mkalkowski83/tank-level/README.md

# Tank Level Sensor / Czujnik poziomu tanku

| Language | Documentation |
|---|---|
| **English** | [README.en.md](README.en.md) |
| **Polski** | [README.pl.md](README.pl.md) |

Firmware (language-neutral): [`esphome/tank-level-sensor.yaml`](esphome/tank-level-sensor.yaml)
