mkalkowski83/tank-level/docs/README.md

# Documentation / Dokumentacja

## Schematics / Schematy

| Topic | English | Polski |
|---|---|---|
| Wiring diagram | [wiring-diagram.en.md](schematics/wiring-diagram.en.md) | [wiring-diagram.pl.md](schematics/wiring-diagram.pl.md) |
| DevKit connections | [connections-devkit.en.md](schematics/connections-devkit.en.md) | [connections-devkit.pl.md](schematics/connections-devkit.pl.md) |
| DevKit + AO3401A (active) | [connections-ao3401a.en.md](schematics/connections-ao3401a.en.md) | [connections-ao3401a.pl.md](schematics/connections-ao3401a.pl.md) |
| FireBeetle (target) | [connections-firebeetle.en.md](schematics/connections-firebeetle.en.md) | [connections-firebeetle.pl.md](schematics/connections-firebeetle.pl.md) |
| Schematic (KiCad PDF) | [tank-level-devkit.pdf](schematics/tank-level-devkit.pdf) | [tank-level-devkit.pdf](schematics/tank-level-devkit.pdf) |

## KiCad / KiCad

| Topic | Project |
|---|---|
| DevKit + AO3401A schematic | [tank-level-devkit.kicad_pro](kicad/tank-level-devkit/tank-level-devkit.kicad_pro) — [README.pl.md](kicad/tank-level-devkit/README.pl.md) |

## Design & plan / Specyfikacja i plan

| Document | English | Polski |
|---|---|---|
| Design spec | [design.en.md](superpowers/specs/2026-08-25-tank-level-sensor-design.en.md) | [design.pl.md](superpowers/specs/2026-08-25-tank-level-sensor-design.pl.md) |
| AO3401A migration | [ao3401a-migration.en.md](superpowers/specs/2026-09-02-ao3401a-migration-design.en.md) | [ao3401a-migration.pl.md](superpowers/specs/2026-09-02-ao3401a-migration-design.pl.md) |
| AO3401A implementation plan | [ao3401a-plan.en.md](superpowers/plans/2026-09-02-ao3401a-migration.en.md) | [ao3401a-plan.pl.md](superpowers/plans/2026-09-02-ao3401a-migration.pl.md) |
| Implementation plan | [plan.en.md](superpowers/plans/2026-08-25-tank-level-sensor.en.md) | [plan.pl.md](superpowers/plans/2026-08-25-tank-level-sensor.pl.md) |

## Firmware / Firmware

| Document | English | Polski |
|---|---|---|
| ESPHome guide | [README.en.md](../esphome/README.en.md) | [README.pl.md](../esphome/README.pl.md) |
