mkalkowski83/tank-level/docs/superpowers/plans/2026-09-02-ao3401a-migration.pl.md

> [English](2026-09-02-ao3401a-migration.en.md) · **Polski**

# Migracja AO3401A — plan implementacji

> **For agentic workers:** REQUIRED SUB-SKILL: Use superpowers:subagent-driven-development (recommended) or superpowers:executing-plans to implement this plan task-by-task. Steps use checkbox (`- [ ]`) syntax for tracking.

**Goal:** Zastąpić IRLZ44N tranzystorem AO3401A (P-MOS high-side + NPN), włączyć deep sleep 8 h i zweryfikować układ etapowo bez ryzyka uszkodzenia czujnika lub MT3608.

**Architecture:** Etap 0 = testy ciągłości bez ogniwa. Etap 1 = USB + `enable_deep_sleep: false` + pełne logi. Etap 2 = bateria + deep sleep 8 h + obserwacja HA. Firmware steruje GPIO4 → NPN → Gate P-MOS; HIGH = czujnik ON, bez `inverted`.

**Tech Stack:** ESPHome 2026.8, ESP32 Arduino (`toolchain: platformio`), AO3401A, 2N3904/BC547, MT3608, JSN-SR04T-V3.3.

## Global Constraints

- Sterowanie: GPIO4 **HIGH** = czujnik ON; **bez** `inverted` na `sensor_power`
- `sleep_duration: 8h` (aktywne od etapu 2)
- `pin_sensor_power: GPIO4` — bez zmian
- **Nie** łączyć OUT+ bezpośrednio na DRAIN bez SOURCE (odrzucony high-side N-MOS)
- **Nie** łączyć Q1 na IN− MT3608
- GND czujnika **prosto na GND** (nie przez MOSFET)
- R1 10k: Gate → OUT+ (pull-up); R2 10k: GPIO4 → baza NPN
- DevKit **bez** expansion board
- Ładowarka + panel — poza zakresem tego planu

**Spec:** [`docs/superpowers/specs/2026-09-02-ao3401a-migration-design.pl.md`](../specs/2026-09-02-ao3401a-migration-design.pl.md)  
**Połączenia:** [`docs/schematics/connections-ao3401a.pl.md`](../../schematics/connections-ao3401a.pl.md)

---

## Mapa plików

| Plik | Rola w migracji |
|---|---|
| `esphome/tank-level-sensor.yaml` | `enable_deep_sleep`, `sleep_duration` |
| `esphome/README.pl.md` (+ EN) | Opis trybu etapowego |
| `docs/schematics/connections-ao3401a.pl.md` | Aktywne połączenia (gotowe) |
| `docs/schematics/connections-devkit.pl.md` | Oznaczenie jako historyczny IRLZ44N |
| `docs/superpowers/specs/2026-08-25-tank-level-sensor-design.pl.md` | Aktualizacja aktywnego Q1 po etapie 2 |

---

### Task 1: Etap 0 — hardware (multimetr, ogniwo wyjęte)

**Files:**
- Read: `docs/schematics/connections-ao3401a.pl.md` (sekcja 6, Etap 0)

**Interfaces:**
- Produces: zweryfikowany montaż AO3401A + NPN gotowy do zasilenia

- [ ] **Step 1: Odłącz IRLZ44N** — wyjmij z obwodu; nie montuj równolegle z AO3401A

- [ ] **Step 2: Zamontuj AO3401A + NPN** według schematu:

```
OUT+ ── SOURCE (pin 2)
DRAIN (pin 3) ── VCC czujnika
GND czujnika ── GND
GATE (pin 1) ── R1 10k ── OUT+ ; GATE ── kolektor NPN
Emiter NPN ── GND
GPIO4 ── R2 10k ── baza NPN
```

- [ ] **Step 3: Test ciągłości (ogniwo wyjęte)**

| Pomiar | OK |
|---|-----|
| BAT+ ↔ GND | brak zwarcia |
| SOURCE ↔ OUT+ | ~0 Ω |
| DRAIN ↔ VCC czujnika | ~0 Ω |
| GND czujnika ↔ GND | ~0 Ω |

- [ ] **Step 4: Commit** (opcjonalnie, jeśli zmiany tylko fizyczne — pomiń)

---

### Task 2: Etap 1 — firmware testowy (USB, deep sleep OFF)

**Files:**
- Modify: `esphome/tank-level-sensor.yaml:13-16`
- Modify: `esphome/README.pl.md`, `esphome/README.en.md`
- Test: logi USB

**Interfaces:**
- Consumes: hardware z Task 1
- Produces: firmware z `enable_deep_sleep: false`, `sleep_duration: 8h`

- [ ] **Step 1: Ustaw substitutions w YAML**

```yaml
  enable_deep_sleep: "false"   # Etap 1 AO3401A: logi USB; etap 2 → "true"
  enable_sensor_power: "true"
  sleep_duration: 8h         # Aktywne od etapu 2
```

- [ ] **Step 2: Potwierdź brak `inverted` na `sensor_power`**

```yaml
switch:
  - platform: gpio
    pin: ${pin_sensor_power}
    id: sensor_power
    # BEZ inverted — HIGH = czujnik ON (AO3401A + NPN)
```

- [ ] **Step 3: Kompilacja i flash (ręcznie)**

```bash
esphome run esphome/tank-level-sensor.yaml
```

Expected: kompilacja OK, urządzenie online w HA.

- [ ] **Step 4: Test napięć (USB + MT3608 zasilony)**

| Stan | Pomiar | OK |
|---|---|-----|
| Po resecie / między pomiarami | VCC czujnika | **~0 V** |
| Podczas `measure_cycle` (GPIO4 HIGH) | VCC czujnika | **~4,8–5 V** |
| Zawsze | OUT+ MT3608 | **~5,0 V** |

- [ ] **Step 5: Logi USB**

```bash
esphome logs esphome/tank-level-sensor.yaml
```

Expected co ~30 s (bez deep sleep):
```
=== measure_cycle #N START ===
Ultrasonic OK: raw=...
=== measure_cycle END (ok=1) ===
```

**Nie** oczekuj `Beginning sleep` — deep sleep wyłączony.

- [ ] **Step 6: 5–10 pomiarów** — stabilne `Tank Distance` w HA

- [ ] **Step 7: Commit**

```bash
git add esphome/tank-level-sensor.yaml esphome/README.pl.md esphome/README.en.md
git commit -m "Configure stage-1 AO3401A firmware (USB debug, no deep sleep)."
```

---

### Task 3: Etap 2 — bateria + deep sleep 8 h

**Files:**
- Modify: `esphome/tank-level-sensor.yaml:13`
- Modify: `docs/superpowers/specs/2026-08-25-tank-level-sensor-design.pl.md`
- Modify: `docs/schematics/connections-devkit.pl.md` (banner historyczny)

**Interfaces:**
- Consumes: Task 2 zaliczony (VCC 0V↔5V, pomiar OK na USB)

- [ ] **Step 1: Włącz deep sleep**

```yaml
  enable_deep_sleep: "true"
```

- [ ] **Step 2: Flash, odłącz USB, zostaw tylko baterię**

- [ ] **Step 3: Po ~8 h sprawdź HA** — nowy `Tank Distance`, `Battery Voltage`

- [ ] **Step 4: Commit + aktualizacja głównej spec**

```bash
git commit -m "Enable 8h deep sleep after AO3401A stage-1 verification."
```

---

### Task 4: Dokumentacja po migracji

**Files:**
- Modify: `docs/schematics/connections-devkit.pl.md` — banner „historyczny IRLZ44N”
- Modify: `docs/superpowers/specs/2026-08-25-tank-level-sensor-design.pl.md` — AO3401A aktywny, wynik baterii
- Modify: `docs/superpowers/plans/2026-08-25-tank-level-sensor.pl.md` — faza 8 → done

- [ ] **Step 1: Oznacz connections-devkit jako historyczny** (link do connections-ao3401a)

- [ ] **Step 2: Zaktualizuj główną spec** — Q1 = AO3401A+NPN, sleep 8h, ~3 dni IRLZ44N w ograniczeniach

- [ ] **Step 3: Commit dokumentacji**

---

## Weryfikacja końcowa etapu 1

| Kryterium | Jak sprawdzić |
|---|---|
| VCC OFF ≈ 0 V | multimetr przy GPIO4 LOW / między cyklami |
| VCC ON ≈ 5 V | multimetr podczas measure_cycle |
| Pomiar OK | log `Ultrasonic OK` |
| Brak deep sleep | brak `Beginning sleep` w logach |
| MT3608 nie gorący | dotyk po 5 min pracy |

## Ryzyka

| Ryzyko | Mitygacja |
|---|---|
| Zła orientacja AO3401A | sprawdź G/S/D na adapterze |
| VCC ≈ 5 V przy OFF | brak NPN lub zły pinout |
| MT3608 gorący | zwarcie; nie Q1 na IN− |
| Brak logów | normalne po etapie 2; etap 1 = USB |
