mkalkowski83/tank-level/docs/schematics/tank-level-devkit.pdf

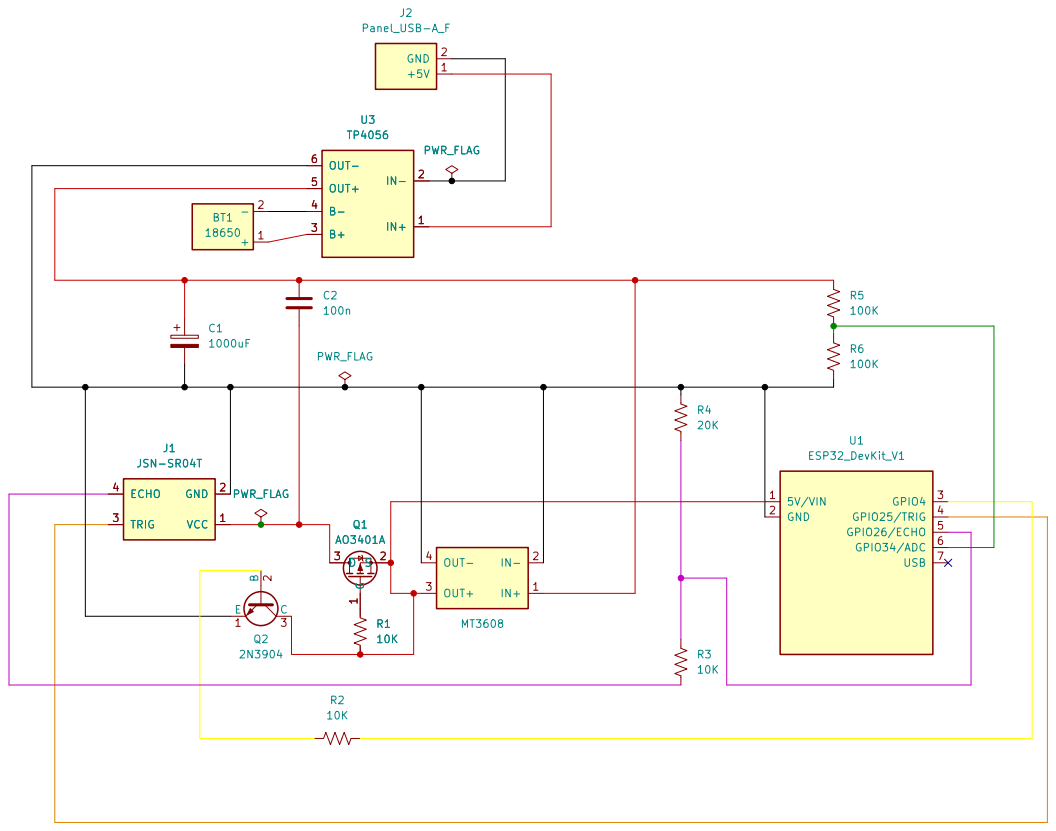
[picture p1: page 1]

Sheet: /
File: tank-level-devkit.kicad_sch
Title: Tank level sensor with battery

Size: A3 | Rev: 0.3-erc | F Date: 2026-09-08
KiCad E.D.A. 10.0.6 | Id: 1/1
