mkalkowski83/tank-level/docs/tank-level-230V.pdf

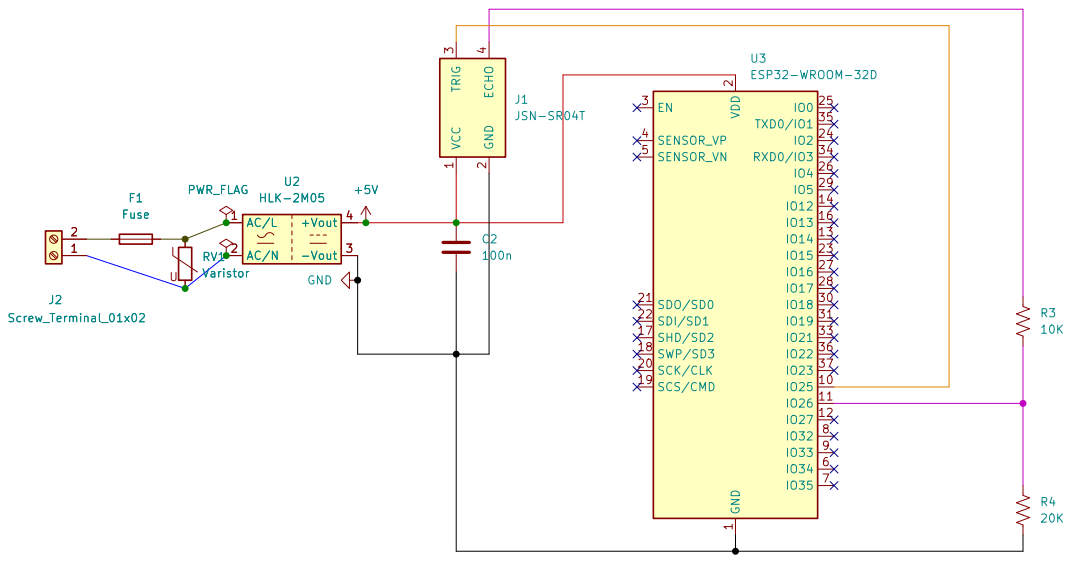
[picture p2: page 1]

Size: A4 | Rev:
KiCad E.D.A. 10.0.6 | Id: 1/1
