mkalkowski83/tank-level/docs/kicad/tank-level-devkit/tank-level-devkit.kicad_pcb

## KiCad design docs/kicad/tank-level-devkit/tank-level-devkit.kicad_pcb (2026-09-16)

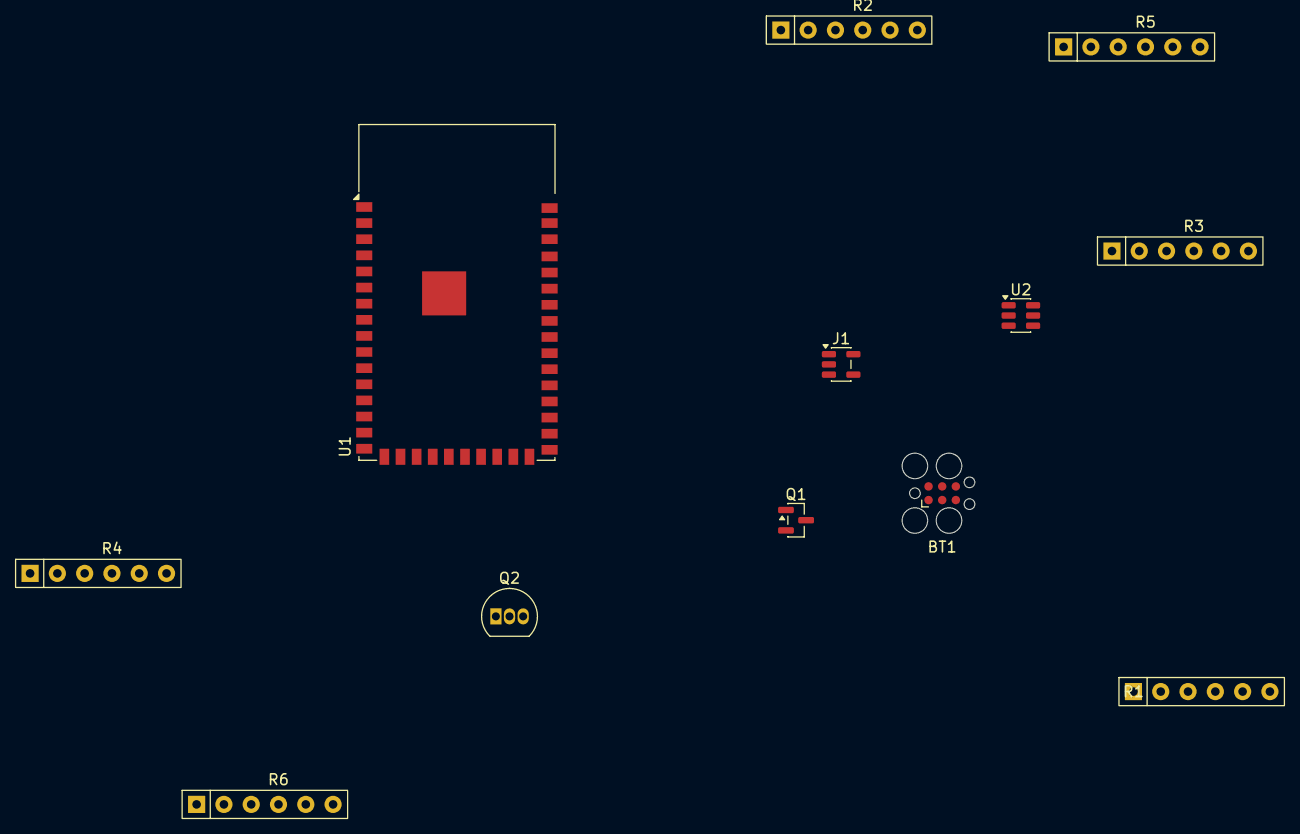
[picture p3: board tank-level-devkit.kicad_pcb from above]

Board: 2 copper layers, 12 parts (0 on the bottom side), 11 nets, no tracks yet.

Parts:
BT1: 18650; Tag-Connect_TC2030-IDC-FP_2x03_P1.27mm_Vertical
J1: JSN-SR04T; SOT-23-5
Q1: AO3401A; SOT-23
Q2: 2N3904; TO-92_Inline
R1, R2, R3: 10K; R_Array_SIP6
R4: 20K; R_Array_SIP6
R5, R6: 100K; R_Array_SIP6
U1: ESP32_DevKit_V1; ESP32-S2-WROVER
U2: MT3608; SOT-23-6

Connections:
unnamed: J1.4 (ECHO), R3.2
unnamed: J1.2 (GND), Q2.1 (E), R4.1, R6.2, U1.2 (GND), U2.2 (IN-), U2.4 (OUT-)
unnamed: J1.3 (TRIG), U1.4 (GPIO25/TRIG)
unnamed: J1.1 (VCC), Q1.3 (D)
unnamed: Q1.1 (G), R1.1
unnamed: Q1.2 (S), Q2.3 (C), R1.2, U1.1 (5V/VIN), U2.3 (OUT+)
unnamed: Q2.2 (B), R2.1
unnamed: R2.2, U1.3 (GPIO4)
unnamed: R3.1, R4.2, U1.5 (GPIO26/ECHO)
unnamed: R5.2, R6.1, U1.6 (GPIO34/ADC)
unnamed: R5.1, U2.1 (IN+)
