mkalkowski83/tank-level/(commit log)

2026-09-02 Add tank level sensor project with ESPHome firmware and docs.
    Includes battery-powered ESP32 prototype, wiring diagrams, design spec,
    and Home Assistant integration for ultrasonic septic tank monitoring.
2026-09-02 Add bilingual documentation (English and Polish).
    Split all docs into .en.md and .pl.md pairs with language switchers,
    replace legacy Polish-only filenames, and add docs/README index.
    [szambo-level-sensor.yaml]
2026-09-02 Rename project to tank-level and update bilingual block diagrams.
    Replace szambo naming with tank across firmware and docs; add EN/PL SVG and PNG overview diagrams reflecting current DevKit wiring (GPIO4 MOSFET, GPIO34 battery divider, MT3608 power).
    [tank-level-sensor.yaml]
2026-09-02 Add AO3401A migration spec and wiring documentation.
    Documents the staged hardware migration from IRLZ44N to P-MOS high-side
    with NPN gate driver, 8h deep sleep, safe test procedure, and field battery results.
2026-09-05 Add AO3401A implementation plan and stage 1 firmware settings.
    Document two-stage migration rollout in EN/PL plans, link from docs index, and configure tank-level-sensor.yaml for stage 1 (deep sleep off, 8h sleep duration for stage 2).
2026-09-09 Add KiCad schematic and stage-1 manual-measure firmware.
    Document the verified AO3401A breadboard circuit in KiCad and extend ESPHome with HA-only measurement controls for safe hardware bring-up.
    [tank-level-devkit.kicad_sch]
2026-09-10 Add TP4056 charger symbols and fix KiCad ERC wiring.
    Custom tank-level symbols for TP4056, solar panel, and BAT18650 pin layout;
    update schematic power types and GND handling; document ERC rules in README.
    [tank-level-devkit.kicad_sch]
2026-09-10 Ignore KiCad local artifacts in git.
    Exclude lock files, backups, layout prefs, and editor history from the repo.
2026-09-10 Link KiCad schematic PDF and drop legacy overview images.
    Add tank-level-devkit.pdf to docs; point README and connection guides at it; remove obsolete tank-overview SVG/PNG exports.
2026-09-11 Extend KiCad symbols for charger status and ESP pull-up.
    Add TP4056 CHRG/STDBY and ESP32 3V3/GPIO33 pins so the schematic can document charging detection without editing wires in the repo.
    [tank-level-devkit.kicad_sch]
2026-09-16 Update tank-level KiCad schematic wiring for CHRG and pull-up.
2026-10-30 Update KiCad project files and documentation for tank-level mains sensor
